KobeD123456/Linefollower/readme.md

# LineFollower
<br />
<br />



<br />
<br />
  
## specifications
<br />
microcontroller:
Arduino nano
<br />
motors: 
Gearmotors 9V 30:1
<br />
h-bridge:
DRV8833
<br />
sensors:
QTR-8A
<br />
batteries:
2 x Samsung NR18650
<br />
wireless communication:
HC-05
<br />
distance sensor - motors:
115mm
<br />
weight:
272g
<br />
speed: 
0.619m/s
<br />
