KobeD123456/Linefollower/bill of materials/readme.md

## bill of materials
<br />

|volgnummer|naam|omschrijving|nieuw/recup|kostprijs/stuk|aantal|subtotaal|
|---|----|---|---|---|---|---|
|1|Microcontroller|	Arduino Nano|	Nieuw	|5,4|	1	|5,4
2	|Sensoren|	QTR-8A|	Nieuw|	11,91|	1|	11,91|
3|	H-brug	|DRV8833|	Nieuw|	6,5|	1	|6,5|
4|	Bluetooth module|	HC-05|	Nieuw|	4|	1|	4|
5|	Motoren|	Gear motor 9V -30:1|	Nieuw|	7,99|	2	|15,98|
6|	Wielen	|Wielen pair 32x7mm|	Nieuw	|4,32|	1	|4,32|
7	|Batterij	|Samsung NR18650|	Nieuw	|8,49|	2	|16,98|
8	|Led	|Led blauw 5V	|Recup|	0|	1	|0|
9	|Drukknop|	Drukknop |	Recup	|0|	1|	0|
10|	Schakelaar|	Mini wipschakelaar AAN/UIT|	Recup|	0	|1	|0|
11|	Weerstand	|Weerstand 220Ω|	Recup	|0|	1	|0|
12|	Weerstand	|Weerstand 1kΩ|	Recup|	0	|3|	0|
13	|Weerstand|	Weerstand 10kΩ|	Recup	|0|	1	|0|
14	|Prototype board	|Double shielded board 50x70mm|	Nieuw	|0,98|	1	|0,98|
15	|Frame	|Modelkarton	|Recup	|1,51|	1	|1,51|
16|	Motorbracket|	PLA|	Nieuw	|0,34	|2	|0,68|
Totaal prijs:						68,26
