KobeD123456/Linefollower/code/proof of concepts/interrupt/Elektronsich schema.pdf

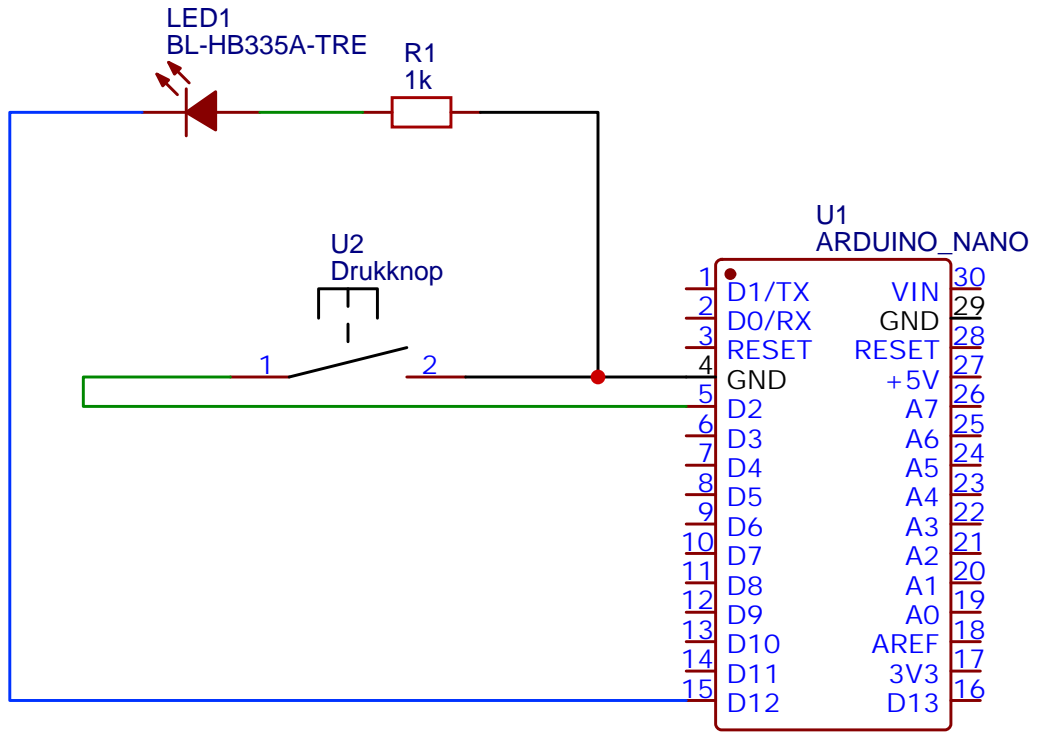
[picture p3: page 1]
