KobeD123456/Linefollower/code/proof of concepts/hbridge/Elektronsich schema.pdf

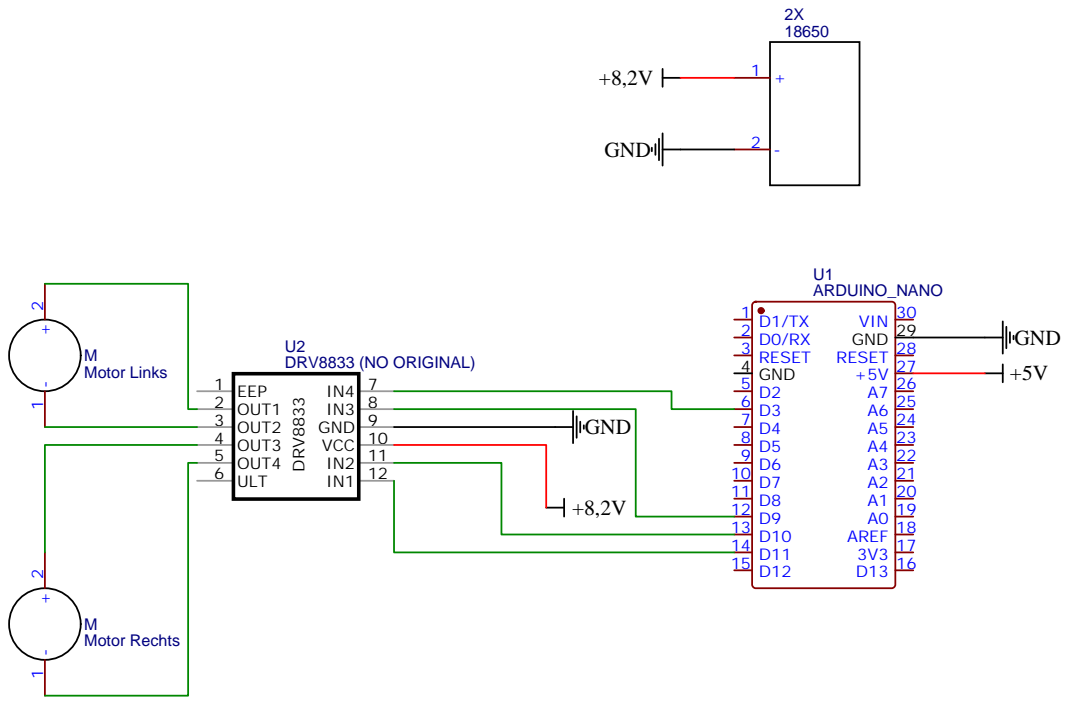
[picture p4: page 1]
