KobeD123456/Linefollower/code/proof of concepts/sensor/Elektronisch schema.pdf

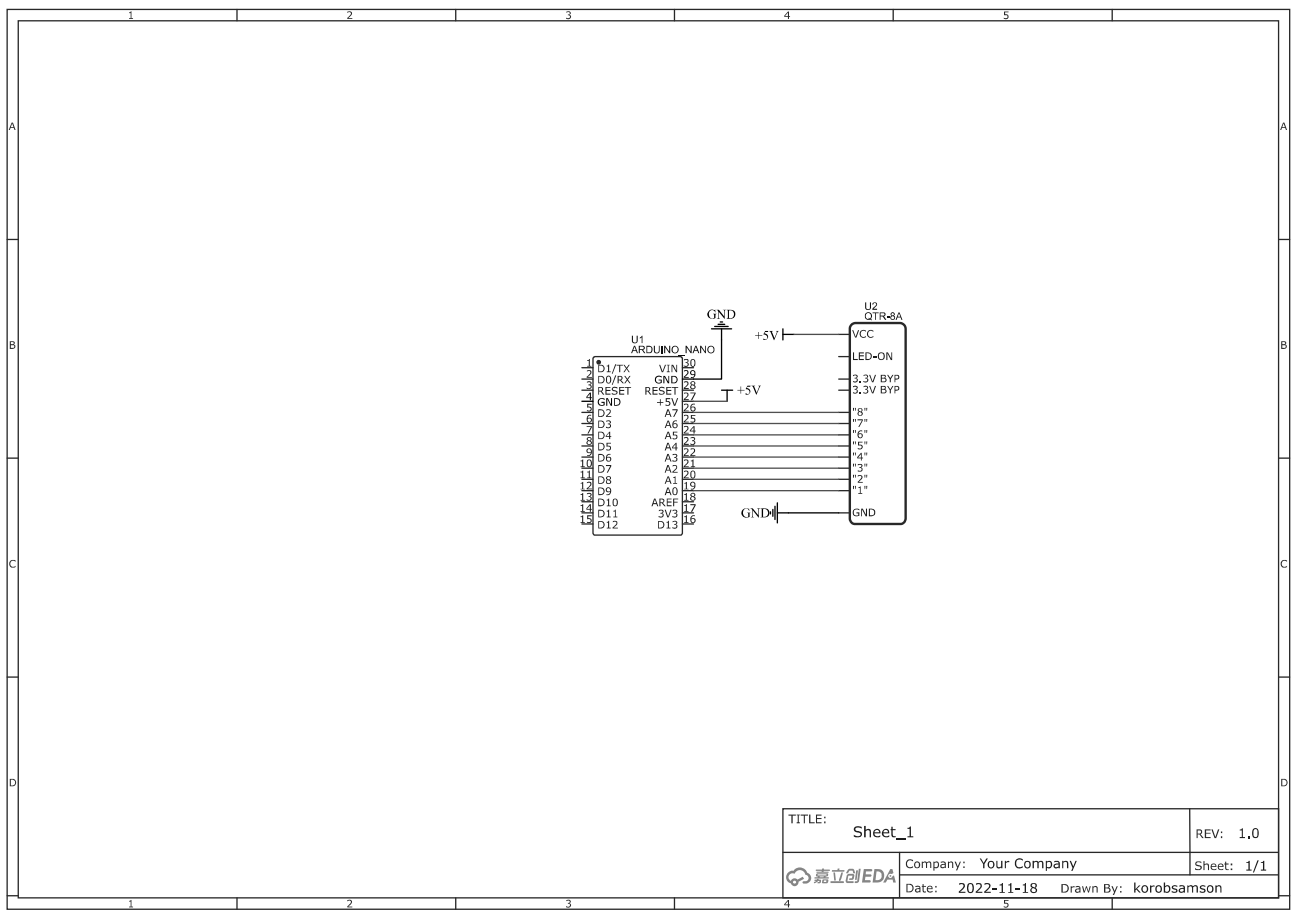
[picture p5: page 1]
